Tepetop/Weather-Station/README.md

# Stacja pogodowa

Coś tu dopisze jeszcze

## AI coding harness

Lokalny agent Python do analizy i edycji kodu STM32, z automatyczną kompilacją
trzech wariantów projektu i testami hosta.

Instrukcja instalacji i przykłady: [tools/ai_harness/README.md](tools/ai_harness/README.md).
