Tepetop/Weather-Station/outdoorPCB/OutdoorMeasureUnit.kicad_pcb

## KiCad design outdoorPCB/OutdoorMeasureUnit.kicad_pcb (2026-09-27)

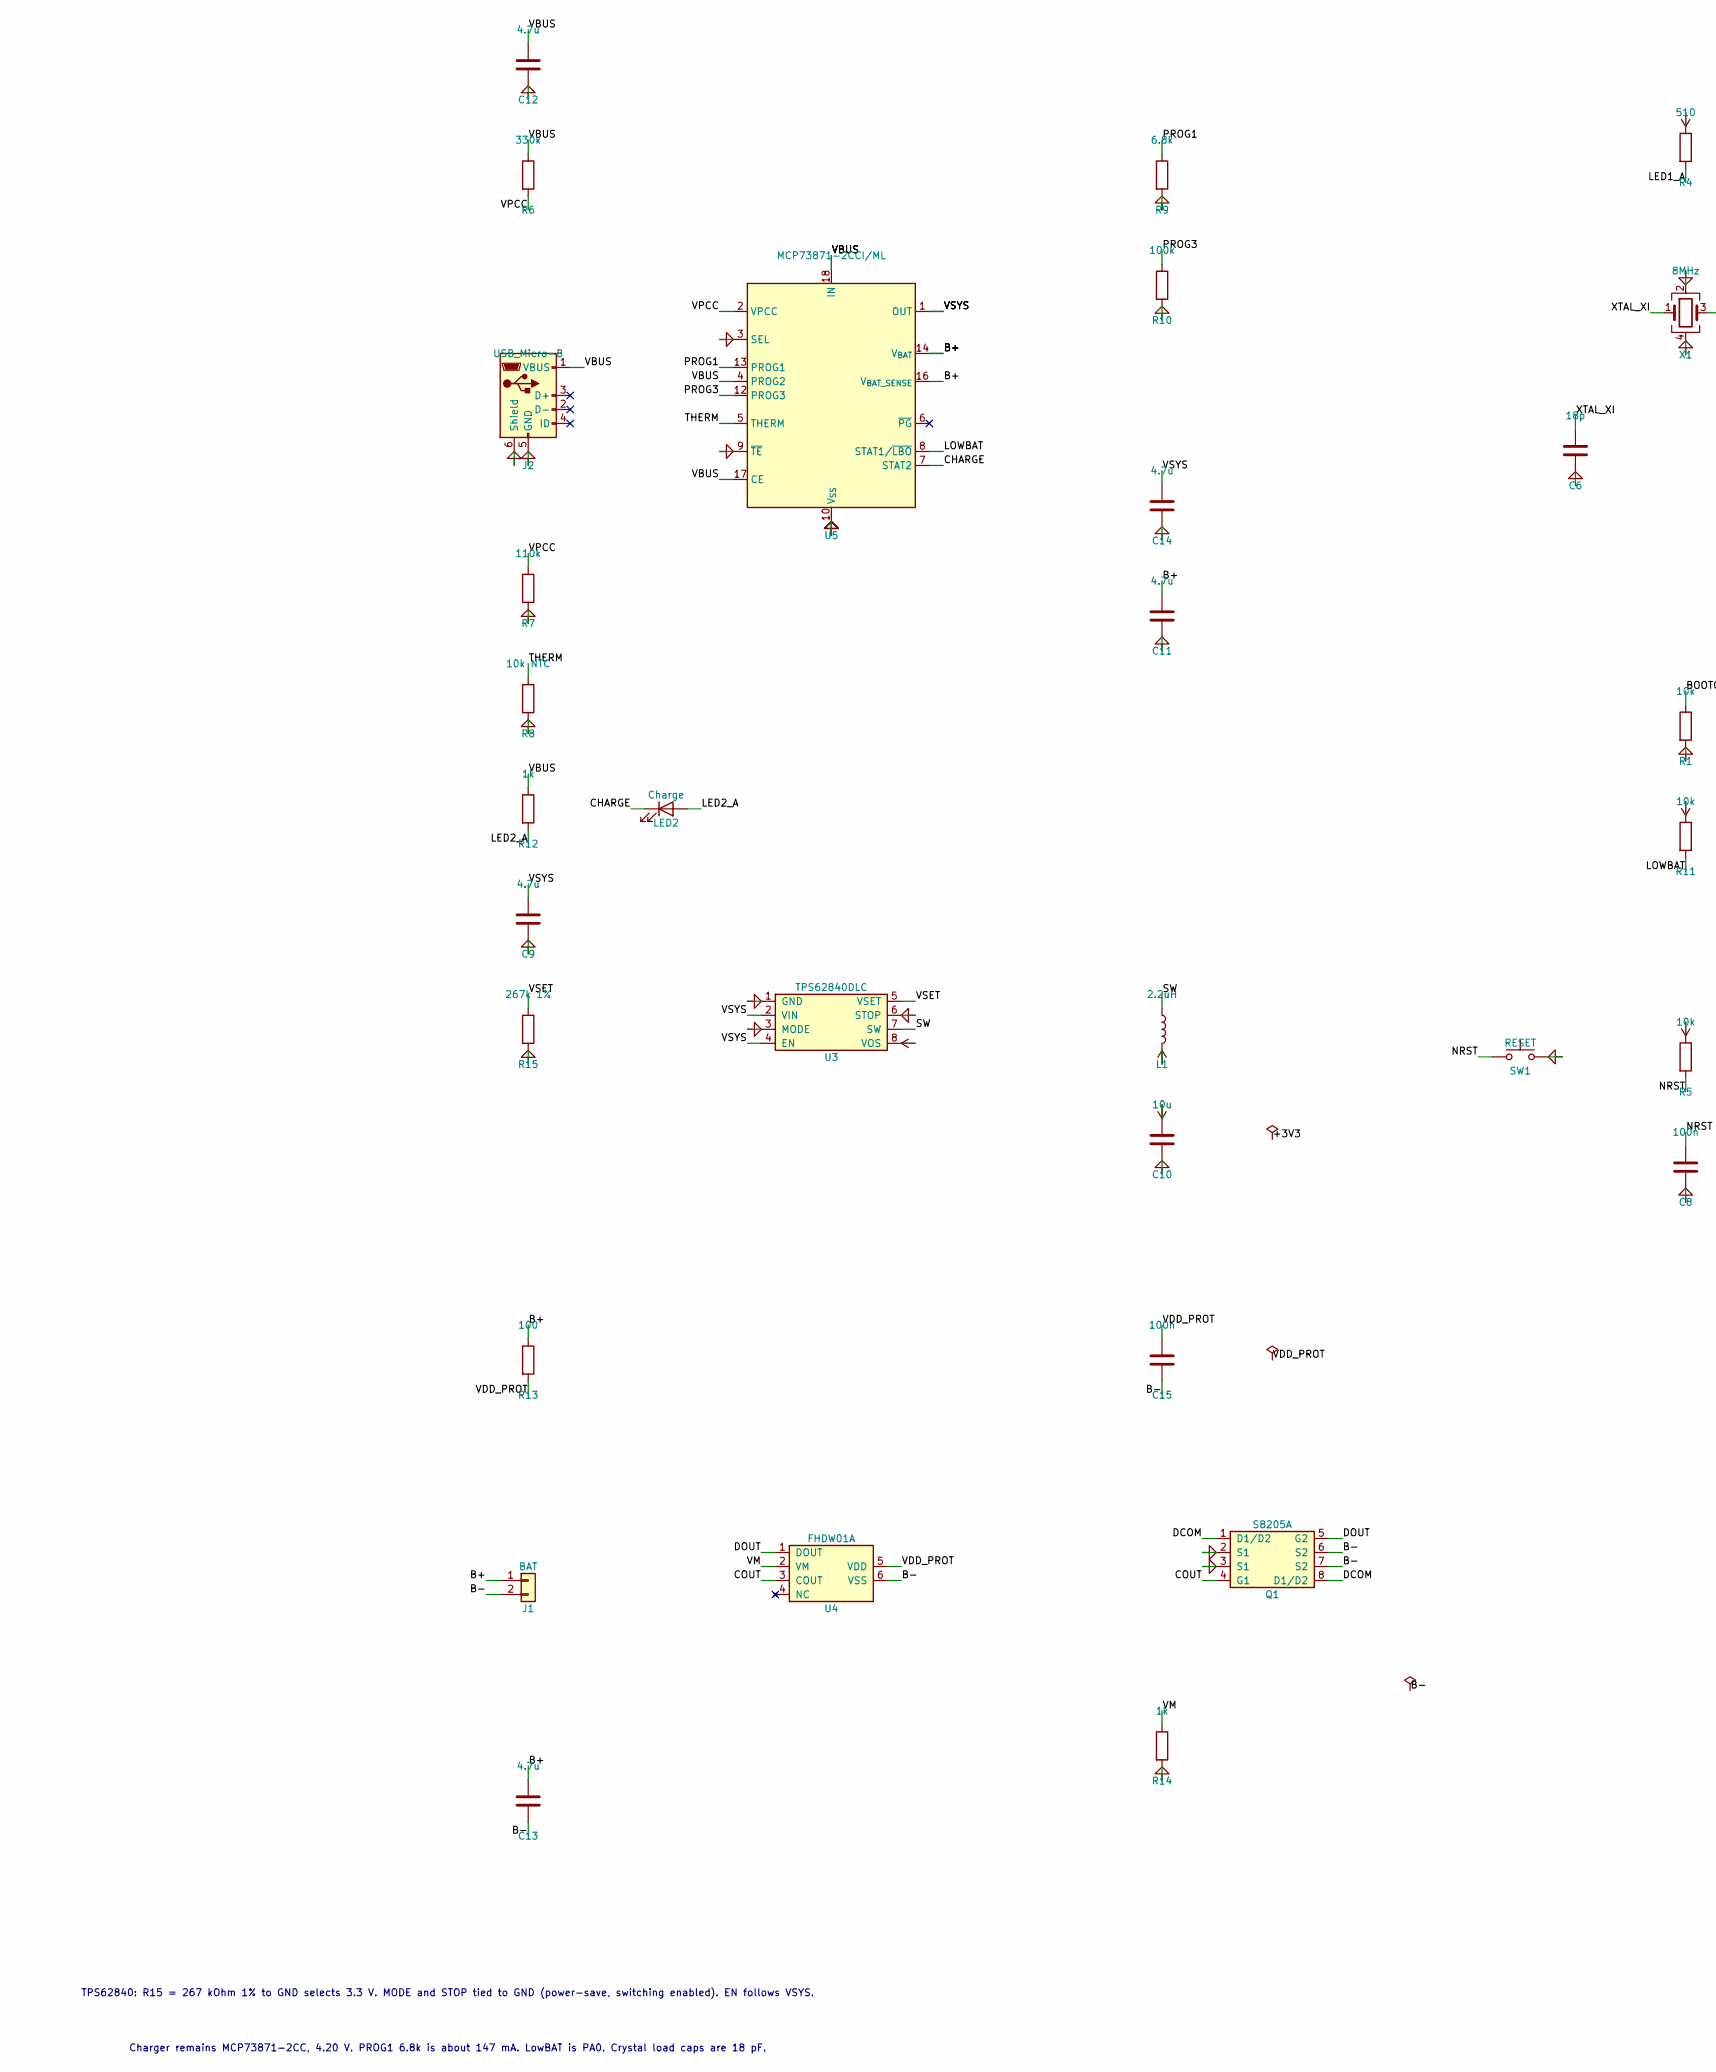
[picture p1: schematic OutdoorMeasureUnit.kicad_sch, part in row 1, column 1]

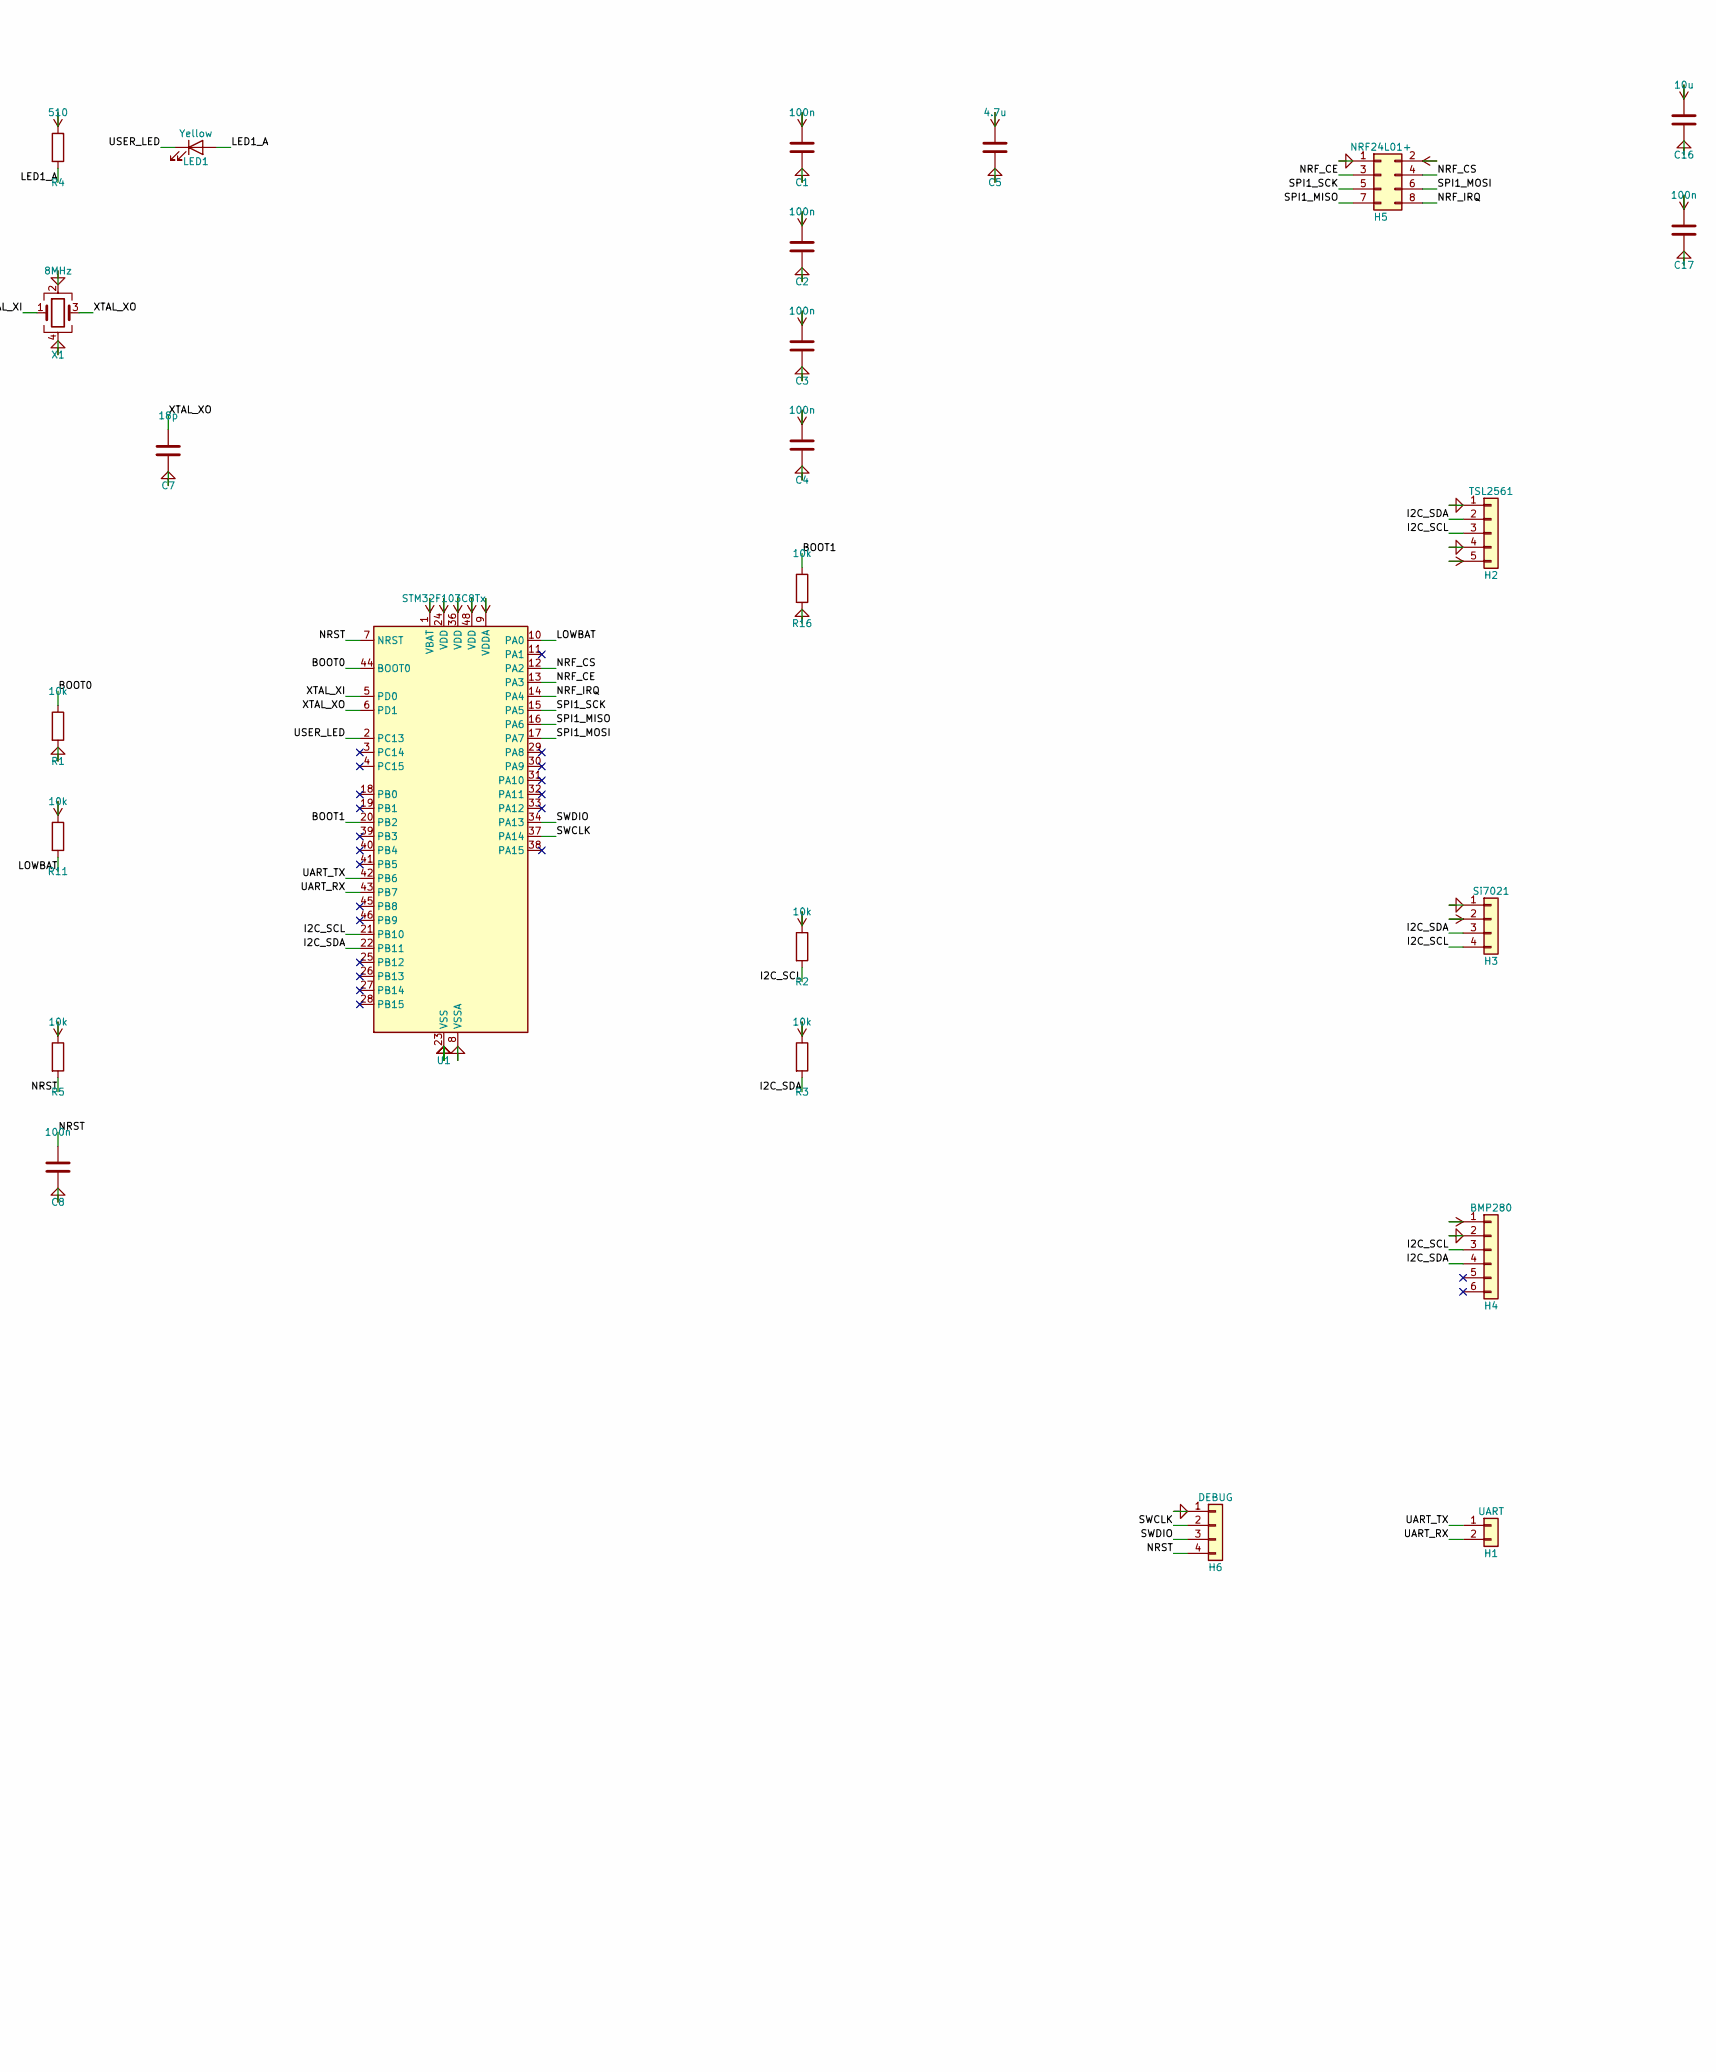
[picture p2: schematic OutdoorMeasureUnit.kicad_sch, part in row 1, column 2]

Parts:
C1, C2, C3, C4, C8, C15, C17: 100n; C_0402_1005Metric
C5, C9, C11, C12, C13, C14: 4.7u; C_0603_1608Metric
C6, C7: 18p; C_0402_1005Metric
C10, C16: 10u; C_0603_1608Metric
H1: UART; PinHeader_1x02_P2.54mm_Vertical
H2: TSL2561; PinHeader_1x05_P2.54mm_Vertical
H3: Si7021; PinHeader_1x04_P2.54mm_Vertical
H4: BMP280; PinHeader_1x06_P2.54mm_Vertical
H5: NRF24L01+; PinHeader_2x04_P2.54mm_Vertical
H6: DEBUG; PinHeader_1x04_P2.54mm_Vertical
J1: BAT; JST_PH_B2B-PH-K_1x02_P2.00mm_Vertical
J2: USB_Micro-B; USB_Micro-B_Molex_47346-0001
L1: 2.2uH; L_Cenker_CKCS201610
LED1: Yellow; LED_0402_1005Metric
LED2: Charge; LED_0402_1005Metric
Q1: S8205A; TSSOP-8_4.4x3mm_P0.65mm
R1, R2, R3, R5, R11, R16: 10k; R_0402_1005Metric
R4: 510; R_0402_1005Metric
R6: 330k; R_0402_1005Metric
R7: 110k; R_0402_1005Metric
R8: 10k NTC; R_0402_1005Metric
R9: 6.8k; R_0402_1005Metric
R10: 100k; R_0402_1005Metric
R12, R14: 1k; R_0402_1005Metric
R13: 100; R_0402_1005Metric
R15: 267k 1%; R_0402_1005Metric
SW1: RESET; SW_SPST_B3U-1000P
U1: STM32F103C8Tx; LQFP-48_7x7mm_P0.5mm
U3: TPS62840DLC; Texas_VSON-HR-8_1.5x2mm_P0.5mm
U4: FHDW01A; SOT-23-6
U5: MCP73871-2CCI/ML; QFN-20-1EP_4x4mm_P0.5mm_EP2.5x2.5mm
X1: 8MHz; Crystal_SMD_3225-4Pin_3.2x2.5mm

Connections:
+3V3: C1.1, C2.1, C3.1, C4.1, C5.1, C10.1, C16.1, C17.1, H2.5, H3.2, H4.1, H5.2, L1.2, R2.1, R3.1, R4.1, R5.1, R11.1, U1.1 (VBAT), U1.9 (VDDA), U1.24 (VDD), U1.36 (VDD), U1.48 (VDD), U3.8 (VOS)
B+: C11.1, C13.1, J1.1, R13.1, U5.14 (V_{BAT}), U5.15 (V_{BAT}), U5.16 (V_{BAT_SENSE})
B-: C13.2, C15.2, J1.2, Q1.6 (S2), Q1.7 (S2), U4.6 (VSS)
BOOT0: R1.1, U1.44 (BOOT0)
BOOT1: R16.1, U1.20 (PB2)
CHARGE: LED2.1 (K), U5.7 (STAT2)
COUT: Q1.4 (G1), U4.3 (COUT)
DCOM: Q1.1 (D1/D2), Q1.8 (D1/D2)
DOUT: Q1.5 (G2), U4.1 (DOUT)
GND: C1.2, C2.2, C3.2, C4.2, C5.2, C6.2, C7.2, C8.2, C9.2, C10.2, C11.2, C12.2, C14.2, C16.2, C17.2, H2.1, H2.4, H3.1, H4.2, H5.1, H6.1, J2.5 (GND), J2.6 (Shield), Q1.2 (S1), Q1.3 (S1), R1.2, R7.2, R8.2, R9.2, R10.2, R14.2, R15.2, R16.2, SW1.2, U1.8 (VSSA), U1.23 (VSS), U1.35 (VSS), U1.47 (VSS), U3.1 (GND), U3.3 (MODE), U3.6 (STOP), U5.3 (SEL), U5.9 (~TE), U5.10 (V_{SS}), U5.11 (V_{SS}), U5.21 (V_{SS}), X1.2, X1.4
I2C_SCL: H2.3, H3.4, H4.3, R2.2, U1.21 (PB10)
I2C_SDA: H2.2, H3.3, H4.4, R3.2, U1.22 (PB11)
LED1_A: LED1.2 (A), R4.2
LED2_A: LED2.2 (A), R12.2
LOWBAT: R11.2, U1.10 (PA0), U5.8 (STAT1/~LBO)
NRF_CE: H5.3, U1.13 (PA3)
NRF_CS: H5.4, U1.12 (PA2)
NRF_IRQ: H5.8, U1.14 (PA4)
NRST: C8.1, H6.4, R5.2, SW1.1, U1.7 (NRST)
PROG1: R9.1, U5.13 (PROG1)
PROG3: R10.1, U5.12 (PROG3)
SPI1_MISO: H5.7, U1.16 (PA6)
SPI1_MOSI: H5.6, U1.17 (PA7)
SPI1_SCK: H5.5, U1.15 (PA5)
SW: L1.1, U3.7 (SW)
SWCLK: H6.2, U1.37 (PA14)
SWDIO: H6.3, U1.34 (PA13)
THERM: R8.1, U5.5 (THERM)
UART_RX: H1.2, U1.43 (PB7)
UART_TX: H1.1, U1.42 (PB6)
USER_LED: LED1.1 (K), U1.2 (PC13)
VBUS: C12.1, J2.1 (VBUS), R6.1, R12.1, U5.4 (PROG2), U5.17 (CE), U5.18 (IN), U5.19 (IN)
VDD_PROT: C15.1, R13.2, U4.5 (VDD)
VM: R14.1, U4.2 (VM)
VPCC: R6.2, R7.1, U5.2 (VPCC)
VSET: R15.1, U3.5 (VSET)
VSYS: C9.1, C14.1, U3.2 (VIN), U3.4 (EN), U5.1 (OUT), U5.20 (OUT)
XTAL_XI: C6.1, U1.5 (PD0), X1.1
XTAL_XO: C7.1, U1.6 (PD1), X1.3

Notes on the sheet:
TPS62840: R15 = 267 kOhm 1% to GND selects 3.3 V. MODE and STOP tied to GND (power-save, switching enabled). EN follows VSYS.
Charger remains MCP73871-2CC, 4.20 V. PROG1 6.8k is about 147 mA. LowBAT is PA0. Crystal load caps are 18 pF.

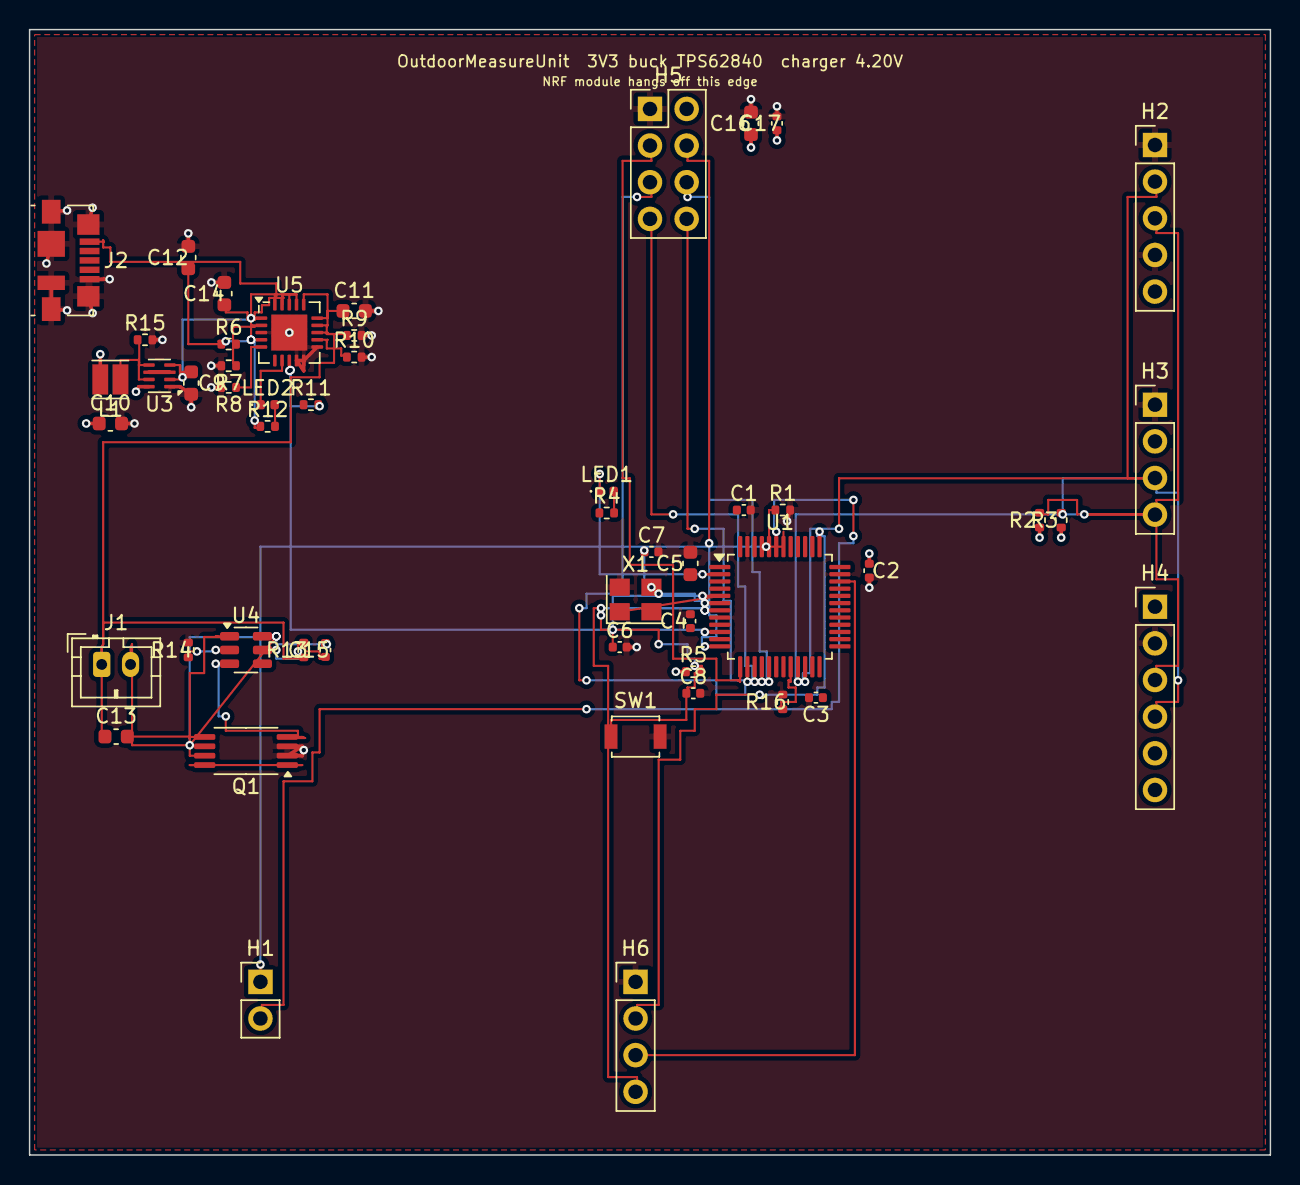
[picture p3: board OutdoorMeasureUnit.kicad_pcb from above]

Board: 4 copper layers, 86.0 x 78.0 mm, 51 parts (0 on the bottom side), 39 nets.
