Tepetop/Weather-Station/IndoorUnit_newMCU/Core/Src/main.c

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
/* Includes ------------------------------------------------------------------*/
#include "main.h"
#include "dma.h"
#include "fatfs.h"
#include "i2c.h"
#include "spi.h"
#include "tim.h"
#include "usart.h"
#include "wwdg.h"
#include "gpio.h"

/* USER CODE BEGIN Includes */
#include <PCD_LCD/PCD8544.h>
#include <PCD_LCD/PCD8544_fonts.h>
#include <PCD_LCD/PCD8544_Menu.h>
#include <PCD_LCD/PCD8544_Menu_config.h>
#include <PCD_LCD/PCD8544_Drawing.h>

#include <complex.h>
#include <stdbool.h>
#include <stdint.h>
#include <stdio.h>
#include <string.h>
#include <sys/_types.h>

#include "weather_station_config.h"
#include "debug_log.h"
#include "uart_cmd.h"
#include "power_mgr.h"
#include "sd_logger.h"
/* USER CODE END Includes */


void SystemClock_Config(void);
/* USER CODE BEGIN PFP */

void EncoderButtonPress(void);
static void NRF_DelayUs(uint32_t us);
void RTC_alarm1(void);
void RTC_alarm2(void);
static bool RTC_IsManualSetRequestedAtBoot(void);
void Menu_EscapeWraper (void);

/* USER CODE END PFP */

/**
  * @brief  The application entry point.
  * @retval int
  */
int main(void)
{

  /* MCU Configuration--------------------------------------------------------*/

  /* Reset of all peripherals, Initializes the Flash interface and the Systick. */
  HAL_Init();

  /* Configure the system clock */
  SystemClock_Config();

  /* Initialize all configured peripherals */
  MX_GPIO_Init();
  MX_DMA_Init();
  MX_I2C2_Init();
  MX_SPI1_Init();
  MX_SPI2_Init();
  MX_TIM1_Init();
  MX_USART1_UART_Init();
  MX_FATFS_Init();
  /* USER CODE BEGIN 2 */
  /* Do NOT call MX_WWDG_Init() here (Cube may regenerate it above): WWDG must
   * start only after long boot init, with Prescaler=8 / Window=126 / Counter=127. */
  /* SPI1 shared by LCD + SD: keep CS idle-high before talking to either. */


  bool rtcManualSetRequested = RTC_IsManualSetRequestedAtBoot();

  /*            Initialize encoder        */
  Encoder_Init(&encoder, &htim1, TIM_CHANNEL_1, TIM_CHANNEL_2);   

  /*             Initialize debounce button        */
  ButtonInitKey(&encoderSW, ENC_BUTTON_GPIO_Port, ENC_BUTTON_Pin, 50, 1000, 500, BUTTON_MODE_INTERRUPT);
  ButtonRegisterPressCallback(&encoderSW, EncoderButtonPress);

  /*            Initialize LCD           */
  if(PCD8544_Init(&LCD, &hspi1, LCD_DC_GPIO_Port, LCD_DC_Pin, LCD_CE_GPIO_Port, LCD_CE_Pin, LCD_RST_GPIO_Port, LCD_RST_Pin, LCD_BLK_GPIO_Port, LCD_BLK_Pin) != PCD_OK) {
    Error_Handler();
  }
  else {
  {
    PCD8544_ClearScreen(&LCD);
  }
  }
 
  /*            Initialize RTC        */
  if (DS3231_Init(&rtc, &hi2c2, RTC_SQW_GPIO_Port, RTC_SQW_Pin, DS3231_I2C_ADDR, DS3231_FORMAT_24H) != DS3231_OK) {
    Error_Handler();
  }

  if (DS3231_GetOscillatorStopFlag(&rtc) != DS3231_OK) {
    Error_Handler();
  }

  if (rtcManualSetRequested || rtc.oscilator_stopped) 
  {
    /* Set time once on manual request or after oscillator stop (OSF=1). */
    if (DS3231_SetDateTime(&rtc, &currentDateTime) != DS3231_OK) {
      Error_Handler();
    }

    if (DS3231_ClearOscillatorStopFlag(&rtc) != DS3231_OK) {
      Error_Handler();
    }

    rtcNow = currentDateTime;
  } else {
    if (DS3231_GetDateTime(&rtc, &rtcNow) != DS3231_OK) {
      Error_Handler();
    }
  }

  DS3231_SetAlarm1(&rtc, &RTCalarm1);
  DS3231_SetAlarm2(&rtc, &RTCalarm2);
  DS3231_EnableAlarm1Interrupt(&rtc);
  DS3231_EnableAlarm2Interrupt(&rtc);

  /* UART + RTC are up: start debug log before SD so init messages are visible. */
  Debug_Init();

  /* SD mount is best-effort — missing card must not block the station. */
  (void)SD_Logger_Init();


  /* Initialize menu system with predefined configuration */
  Menu_Init(&StronaDomyslna, &menuContext); 
  // Set font for menu display
  PCD8544_SetFont(&LCD, &Font_6x8);  
  // Display initial menu and then show default measurement screen
  Menu_RefreshDisplay(&LCD, &menuContext);
  
  /* Initialize charts (no-op when WS_UI_CHARTS_ENABLED == 0) */
  WS_UI_InitCharts();

  /* ---------------------------------------------------------------
   * NRF24L01 Weather Station Initialization
   * --------------------------------------------------------------- */

  /* 1. Initialize nRF24L01 driver handle. */
  if (NRF24_Init(&nrf, &hspi2, NRF_CS_GPIO_Port, NRF_CS_Pin, NRF_CE_GPIO_Port, NRF_CE_Pin, NRF_IRQ_GPIO_Port, NRF_IRQ_Pin, NRF_DelayUs) != HAL_OK) 
  {
    PCD8544_SetFont(&LCD, &Font_6x8);
    PCD8544_SetCursor(&LCD, 0, 0);
    PCD8544_WriteString(&LCD, "NRF FAIL");
    PCD8544_UpdateScreen(&LCD);
    Error_Handler();
  }

  if (NRF24_IsPresent(&nrf) != HAL_OK)
  {
    PCD8544_SetFont(&LCD, &Font_6x8);
    PCD8544_SetCursor(&LCD, 0, 0);
    PCD8544_WriteString(&LCD, "NRF MISS");
    PCD8544_UpdateScreen(&LCD);
    Error_Handler();
  }

  WS_InitManager(&wsCtx, WS_NODE_TX_ADDRS, WS_NODE_RX_ADDRS, WS_NODE_COUNT);


  /*  Initialize Weather Station Runtime struct   */  
  wsRuntime.nrf = &nrf;
  wsRuntime.lcd = &LCD;
  wsRuntime.rtc_now = &rtcNow;
  wsRuntime.text_buffer = g_nrf_message;
  wsRuntime.text_buffer_size = sizeof(g_nrf_message);
  wsRuntime.led_port = USER_LED_GPIO_Port;
  wsRuntime.led_pin = USER_LED_Pin;
  wsRuntime.channel = NRF_CHANNEL;
  wsRuntime.cmd_measure = CMD_MEASURE;
  wsRuntime.cmd_size = NRF_CMD_SIZE;
  wsRuntime.payload_size = NRF_PAYLOAD_SIZE;
  wsRuntime.tx_irq_timeout_ms = NRF_TX_IRQ_TIMEOUT_MS;
  wsRuntime.rx_timeout_ms = NRF_RX_TIMEOUT_MS;
  wsRuntime.comm_watchdog_timeout_ms = NRF_COMM_WATCHDOG_TIMEOUT_MS;
  wsRuntime.huart_pico = &huart1;
  wsRuntime.broadcast_addr = NRF_BROADCAST_ADDR;

  /*  If NRF24L01 initialization fails, display error on LCD , go to error handler*/
  if (WS_InitRadioAndStart(&wsCtx, &wsRuntime) != HAL_OK) {
    PCD8544_SetFont(&LCD, &Font_6x8);
    PCD8544_SetCursor(&LCD, 0, 0);
    PCD8544_WriteString(&LCD, "WS INIT ERR");
    PCD8544_UpdateScreen(&LCD);
    Error_Handler();
  }

  /* Initialize UI context for weather station display functions */
  WS_UI_Init(&WS_UI, &wsCtx, &wsRuntime, &LCD, &menuContext, &encoder, &rtcNow, g_nrf_message, sizeof(g_nrf_message), &rtc);

  UartCmd_Init(&huart1, &wsCtx);

  /* Force initial measurement display render (show time + placeholders) */
  WS_UI.chart_data_dirty = 1U;

  /*  Initial measurement request */
  WS_RequestMeasurementCycle(&wsCtx);

  /* Start WWDG only after long boot-time initialization is complete. */
  MX_WWDG_Init();
  uint32_t wwdg_last_refresh_tick = HAL_GetTick();

  PowerMgr_Init();

  /* USER CODE END 2 */

  /* Infinite loop */
  /* USER CODE BEGIN WHILE */
  while (1)
  {
    /* USER CODE END WHILE */

    /* USER CODE BEGIN 3 */

    uint32_t now_tick = HAL_GetTick();

    /* Flush buffered UART reply first so ACK reaches Pico before NRF logs. */
    UartCmd_FlushReply();

    /*  Process with NRF24  */
    WS_ProcessEventHandler(&wsCtx, &wsRuntime, now_tick);

    /*    Process with RTC event     */
    DS3231_EventHandler(&rtc, &rtcNow, RTC_alarm1, RTC_alarm2);

    /*    Process with button event routine    */
    ButtonTask(&encoderSW);

    /* View state machine handles chart, status, measurement and menu views */
    WS_UI_ViewTask();

    /* Keep WWDG alive only while communication watchdog is healthy. */
    uint32_t wwdg_now_tick = HAL_GetTick();
    if ((wsCtx.comm_watchdog_tripped == 0U) && ((wwdg_now_tick - wwdg_last_refresh_tick) >= WWDG_REFRESH_PERIOD_MS)) 
    {
      WWDG_TryRefresh();
      wwdg_last_refresh_tick = wwdg_now_tick;
    }

    /* Debug heartbeat - logs every minute to detect program hangs */
    #ifdef DEBUG_LOG_HEARTBEAT
        Debug_Heartbeat();
    #endif

    if ((menuContext.state.InScreenSaver != 0U) &&
        (encoder.ButtonIRQ_Flag == 0U) &&
        (encoderSW.InterruptFlag == 0U) &&
        (encoder.IRQ_Flag == 0U) &&
        (WS_CanSleep(&wsCtx) != 0U))
    {
      PowerMgr_EnterIdleStop(&nrf);
    }

  }
  /* USER CODE END 3 */
}

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
/* USER CODE BEGIN 4 */

/*      Encoder timer handler     */
void HAL_TIM_IC_CaptureCallback(TIM_HandleTypeDef *htim){
  /*   Check if the interrupt is from TIM1*/
  if (htim->Instance == TIM1)
  {
    encoder.IRQ_Flag = IRQ_FLAG_SET;
  }
}

/*      Encoder button IRQ handler      */
void HAL_GPIO_EXTI_Callback(uint16_t GPIO_Pin)
{
  /*Encoder button IRQ handler*/
  ButtonIRQHandler(&encoderSW, GPIO_Pin);

  /* RTC SQW/INT pin IRQ handler */
  DS3231_IRQHandler(&rtc, GPIO_Pin);

  /* NRF24L01 IRQ pin (active low) */
  if (GPIO_Pin == NRF_IRQ_Pin)
  {
    WS_SetIrqFlag(&wsCtx);
  }
}

/*                PRIVATE FUNCTIONS                             */

/**
 * @brief Microsecond delay using DWT cycle counter.
 */
static void NRF_DelayUs(uint32_t us) {
  CoreDebug->DEMCR |= CoreDebug_DEMCR_TRCENA_Msk;
  DWT->CYCCNT = 0;
  DWT->CTRL |= DWT_CTRL_CYCCNTENA_Msk;

  uint32_t cycles = (SystemCoreClock / 1000000U) * us;
  uint32_t start = DWT->CYCCNT;
  while ((DWT->CYCCNT - start) < cycles);
}

/* RTC alarm function assign to callback */
void RTC_alarm1(void){
  WS_UI.chart_data_dirty = 1U;
#ifdef DEBUG_LOG_RTC1_EVENTS
  Debug_LogRtcAlarm1();
#endif
}

/* RTC alarm function assign to callback */
void RTC_alarm2(void){
  WS_RequestMeasurementCycle(&wsCtx);
#ifdef DEBUG_LOG_RTC2_EVENTS
  Debug_LogRtcAlarm2();
#endif
}

/*      Encoder button function to assign to callback     */
void EncoderButtonPress(void)
{
  encoder.ButtonIRQ_Flag = IRQ_FLAG_SET;
  Menu_SetEnterAction(&menuContext);
}

void Menu_EscapeWraper(void)
{
    Menu_Escape(&LCD, &menuContext);
};

/* Hold encoder button during boot to force one-time manual RTC update. */
static bool RTC_IsManualSetRequestedAtBoot(void){
  uint32_t startTick = HAL_GetTick();

  if (HAL_GPIO_ReadPin(ENC_BUTTON_GPIO_Port, ENC_BUTTON_Pin) != GPIO_PIN_RESET) {
    return false;
  }

  while ((HAL_GetTick() - startTick) < RTC_MANUAL_SET_HOLD_MS) {
    if (HAL_GPIO_ReadPin(ENC_BUTTON_GPIO_Port, ENC_BUTTON_Pin) != GPIO_PIN_RESET) {
      return false;
    }
  }

  return true;
}

/* USER CODE END 4 */
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
