Tepetop/Weather-Station/IndoorUnit_newMCU/Core/Inc/main.h

#define USER_LED_Pin GPIO_PIN_13
#define USER_LED_GPIO_Port GPIOC
#define LCD_BLK_Pin GPIO_PIN_14
#define LCD_BLK_GPIO_Port GPIOC
#define LCD_DC_Pin GPIO_PIN_2
#define LCD_DC_GPIO_Port GPIOA
#define LCD_CE_Pin GPIO_PIN_3
#define LCD_CE_GPIO_Port GPIOA
#define LCD_RST_Pin GPIO_PIN_4
#define LCD_RST_GPIO_Port GPIOA
#define SPI1_CLK_Pin GPIO_PIN_5
#define SPI1_CLK_GPIO_Port GPIOA
#define SPI1_MOSI_Pin GPIO_PIN_7
#define SPI1_MOSI_GPIO_Port GPIOA
#define SD_CS_Pin GPIO_PIN_0
#define SD_CS_GPIO_Port GPIOB
#define RTC_SQW_Pin GPIO_PIN_1
#define RTC_SQW_GPIO_Port GPIOB
#define RTC_SQW_EXTI_IRQn EXTI1_IRQn
#define RTC_SCL_Pin GPIO_PIN_10
#define RTC_SCL_GPIO_Port GPIOB
#define RTC_SDA_Pin GPIO_PIN_11
#define RTC_SDA_GPIO_Port GPIOB
#define NRF_CS_Pin GPIO_PIN_12
#define NRF_CS_GPIO_Port GPIOB
#define NRF_SCK_Pin GPIO_PIN_13
#define NRF_SCK_GPIO_Port GPIOB
#define NRF_MISO_Pin GPIO_PIN_14
#define NRF_MISO_GPIO_Port GPIOB
#define NRF_MOSI_Pin GPIO_PIN_15
#define NRF_MOSI_GPIO_Port GPIOB
#define ENC_CH1_Pin GPIO_PIN_8
#define ENC_CH1_GPIO_Port GPIOA
#define ENC_CH2_Pin GPIO_PIN_9
#define ENC_CH2_GPIO_Port GPIOA
#define ENC_BUTTON_Pin GPIO_PIN_10
#define ENC_BUTTON_GPIO_Port GPIOA
#define ENC_BUTTON_EXTI_IRQn EXTI15_10_IRQn
#define NRF_IRQ_Pin GPIO_PIN_11
#define NRF_IRQ_GPIO_Port GPIOA
#define NRF_IRQ_EXTI_IRQn EXTI15_10_IRQn
#define NRF_CE_Pin GPIO_PIN_12
#define NRF_CE_GPIO_Port GPIOA
#define SD_SPI_HANDLE hspi1
