Tepetop/Weather-Station/IndoorUnit_newMCU/Core/Inc/Sensors/encoder.h

/**
 * @file    encoder.h
 * @brief   Rotary encoder driver for STM32 timer encoder mode
 * @details Reads hardware timer counter deltas and direction (CR1.DIR bit),
 *          accumulates pulse count, and maps rotation to menu navigation.
 */

#ifndef ENCODER_H
#define ENCODER_H

#include "main.h"
#include "PCD8544_Menu.h"


#define ENCODER_TIMER_MIDDLE  0x7FFF
/**
 * @brief Encoder rotation direction (mirrors hardware DIR bit in TIMx->CR1).
 *
 * In encoder mode the timer hardware sets the DIR bit automatically:
 *   DIR = 0 → counter counts UP   → forward  (pin A pulses)
 *   DIR = 1 → counter counts DOWN → backward (pin B pulses)
 */
typedef enum
{
	ENCODER_DIR_FORWARD  = 0,   /**< Counting up   – pin A impulses dominate */
	ENCODER_DIR_BACKWARD = 1    /**< Counting down  – pin B impulses dominate */
} Encoder_Direction_t;

/**
 * @brief Encoder instance structure.
 */
typedef struct
{
	TIM_HandleTypeDef      *EncTim;          /**< Timer handle (encoder mode)            */
	uint16_t                PrevCounter;     /**< Previous CNT snapshot for delta calc    */
	int32_t                 PulseCount;      /**< Net accumulated pulse count (+/-)       */
	Encoder_Direction_t     Direction;       /**< Current direction from CR1.DIR bit      */
	volatile uint8_t        IRQ_Flag;        /**< Set in TIM capture-compare ISR          */
	volatile uint8_t        ButtonIRQ_Flag;  /**< Set in EXTI (button) ISR                */
} Encoder_t;

/* ============================================================================
 * Public API
 * ============================================================================ */

/**
 * @brief   Initializes encoder instance and starts timer in encoder mode
 * @param   encoder   Encoder handle to initialize
 * @param   timer     HAL timer configured for encoder mode
 * @param   channel1  First encoder channel (e.g. TIM_CHANNEL_1)
 * @param   channel2  Second encoder channel (e.g. TIM_CHANNEL_2)
 * @retval  HAL_OK     Initialization successful
 * @retval  HAL_ERROR  NULL pointer argument
 */
HAL_StatusTypeDef   Encoder_Init(Encoder_t *encoder, TIM_HandleTypeDef *timer,
                                 uint32_t channel1, uint32_t channel2);

/**
 * @brief   Samples timer counter and accumulates pulse delta
 * @param   encoder  Encoder handle
 * @retval  HAL_OK     Update successful
 * @retval  HAL_ERROR  NULL pointer argument
 */
HAL_StatusTypeDef   Encoder_Update(Encoder_t *encoder);

/**
 * @brief   Returns current rotation direction from hardware DIR bit
 * @param   encoder  Encoder handle (read-only)
 * @retval  ENCODER_DIR_FORWARD or ENCODER_DIR_BACKWARD
 */
Encoder_Direction_t Encoder_GetDirection(const Encoder_t *encoder);

/**
 * @brief   Returns accumulated signed pulse count
 * @param   encoder  Encoder handle (read-only)
 * @retval  Net pulse count (positive = forward, negative = backward)
 */
int32_t             Encoder_GetPulseCount(const Encoder_t *encoder);

/**
 * @brief   Resets accumulated pulse count to zero
 * @param   encoder  Encoder handle
 * @retval  None
 */
void                Encoder_ResetPulseCount(Encoder_t *encoder);

/**
 * @brief   Consumes one pulse and updates menu navigation action
 * @param   encoder  Encoder handle
 * @param   context  Active menu context
 * @retval  None
 */
void                Encoder_ManageCursorPosition(Encoder_t *encoder, Menu_Context_t *context);

/**
 * @brief   Main-loop task: processes IRQ flags and menu cursor
 * @param   encoder  Encoder handle
 * @param   context  Active menu context
 * @retval  None
 */
void                Encoder_Task(Encoder_t *encoder, Menu_Context_t *context);

#endif /* ENCODER_H */
