Tepetop/Weather-Station/IndoorUnit_newMCU/Core/Src/Sensors/PCD_LCD/PCD8544_fonts.c

/**
 * @file PCD8544_fonts.c
 * @brief Bitmap font glyph data for the PCD8544 display.
 * @details Implements ASCII bitmap arrays and PCD8544_Font_t descriptors
 *          selected at compile time via PCD8544_config.h.
 */

#include "PCD8544_fonts.h"


// Characters definition
#ifdef PCD8544_INCLUDE_FONT6x8
const uint16_t F6x8[] =
{
	0x00, 0x00, 0x00, 0x00, 0x00, 0x00 ,			 // 20 space
	0x00, 0x00, 0x4f, 0x00, 0x00, 0x00 ,			 // 21 !
	0x00, 0x07, 0x00, 0x07, 0x00, 0x00 ,		 // 22 "
	0x14, 0x7f, 0x14, 0x7f, 0x14, 0x00 ,		 // 23 #
	0x24, 0x2a, 0x7f, 0x2a, 0x12, 0x00 ,		 // 24 $
	0x23, 0x13, 0x08, 0x64, 0x62, 0x00 ,		 // 25 %
	0x36, 0x49, 0x55, 0x22, 0x50, 0x00 ,		 // 26 &
	0x00, 0x05, 0x03, 0x00, 0x00, 0x00 ,		 // 27 '
	0x00, 0x1c, 0x22, 0x41, 0x00, 0x00 ,		 // 28 (
	0x00, 0x41, 0x22, 0x1c, 0x00, 0x00 ,		 // 29 )
	0x14, 0x08, 0x3e, 0x08, 0x14, 0x00 ,		 // 2a *
	0x08, 0x08, 0x3e, 0x08, 0x08, 0x00 ,		 // 2b +
	0x00, 0x50, 0x30, 0x00, 0x00, 0x00 ,		 // 2c ,
	0x08, 0x08, 0x08, 0x08, 0x08, 0x00 ,		 // 2d -
	0x00, 0x60, 0x60, 0x00, 0x00, 0x00 ,		 // 2e .
	0x20, 0x10, 0x08, 0x04, 0x02, 0x00 ,		 // 2f /
	0x3e, 0x51, 0x49, 0x45, 0x3e, 0x00 ,	 // 30 0
	0x00, 0x42, 0x7f, 0x40, 0x00, 0x00 , // 31 1
	0x42, 0x61, 0x51, 0x49, 0x46, 0x00 , // 32 2
	0x21, 0x41, 0x45, 0x4b, 0x31, 0x00 , // 33 3
	0x18, 0x14, 0x12, 0x7f, 0x10, 0x00 , // 34 4
	0x27, 0x45, 0x45, 0x45, 0x39, 0x00 , // 35 5
	0x3c, 0x4a, 0x49, 0x49, 0x30, 0x00 , // 36 6
	0x01, 0x71, 0x09, 0x05, 0x03, 0x00 , // 37 7
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
#endif

#ifdef SSD1306_INCLUDE_FONT_11x18
/** @brief 11×18 pixel ASCII font instance */
const PCD8544_Font_t Font_11x18 = {11, 18, Font11x18};
#endif

#ifdef SSD1306_INCLUDE_FONT_16x26
/** @brief 16×26 pixel ASCII font instance */
const PCD8544_Font_t Font_16x26 = {16, 26, Font16x26};
#endif
