Tepetop/Weather-Station/IndoorUnit_newMCU/Core/Src/Sensors/NRF24L01.c

/**
 * @file    NRF24L01.c
 * @brief   nRF24L01+ 2.4 GHz transceiver driver (SPI)
 * @details STM32 HAL SPI driver for Nordic nRF24L01(+). Provides register
 *          access, TX/RX payload handling, IRQ processing, and radio
 *          configuration (channel, data rate, PA level, pipes, CRC).
 *          Static helpers manage CSN/CE timing and SPI transfers.
 */

#include "NRF24L01.h"
#include <string.h>

/* ---------------------------------------------------------------------------
 * Private (static) helper functions
 * --------------------------------------------------------------------------- */

/**
 * @brief Drives CSN (Chip Select Not) pin low to start SPI transaction.
 * @param handle Pointer to the nRF24 handle structure.
 */
static void csn_low(NRF24_Handle_t *handle) {
    HAL_GPIO_WritePin(handle->csn_port, handle->csn_pin, GPIO_PIN_RESET);
}

/**
 * @brief Drives CSN (Chip Select Not) pin high to end SPI transaction.
 * @param handle Pointer to the nRF24 handle structure.
 */
static void csn_high(NRF24_Handle_t *handle) {
    HAL_GPIO_WritePin(handle->csn_port, handle->csn_pin, GPIO_PIN_SET);
}

/**
 * @brief Drives CE (Chip Enable) pin low to deactivate TX/RX mode.
 * @param handle Pointer to the nRF24 handle structure.
 */
static void ce_low(NRF24_Handle_t *handle) {
    HAL_GPIO_WritePin(handle->ce_port, handle->ce_pin, GPIO_PIN_RESET);
}

/**
 * @brief Drives CE (Chip Enable) pin high to activate TX/RX mode.
 * @param handle Pointer to the nRF24 handle structure.
 */
static void ce_high(NRF24_Handle_t *handle) {
    HAL_GPIO_WritePin(handle->ce_port, handle->ce_pin, GPIO_PIN_SET);
}

/**
 * @brief Forces Standby-I before register configuration writes (CE low).
 * @param handle Pointer to the nRF24 handle structure.
 */
static void ensure_standby(NRF24_Handle_t *handle) {
    ce_low(handle);
}

/**
 * @brief Performs a full-duplex SPI transfer.
 * @param handle Pointer to the nRF24 handle structure.
 * @param tx    Pointer to transmit buffer.
 * @param rx    Pointer to receive buffer.
 * @param len   Number of bytes to transfer.
 * @return HAL status.
 */
static HAL_StatusTypeDef spi_transfer(NRF24_Handle_t *handle, uint8_t *tx, uint8_t *rx, uint16_t len) {
    return HAL_SPI_TransmitReceive(handle->hspi, tx, rx, len, HAL_MAX_DELAY);
}

/**
 * @brief Sends a single-byte SPI command and optionally returns the status byte.
 * @param handle Pointer to the nRF24 handle structure.
 * @param cmd    Command byte to send.
 * @param status Pointer to store the returned status byte (may be NULL).
 * @return HAL status.
 */
static HAL_StatusTypeDef command(NRF24_Handle_t *handle, uint8_t cmd, uint8_t *status) {
    uint8_t tx = cmd;
    uint8_t rx;
    csn_low(handle);
    HAL_StatusTypeDef ret = spi_transfer(handle, &tx, &rx, 1);
    csn_high(handle);
    if (status) *status = rx;
    return ret;
}

/**
 * @brief Writes a multi-byte payload over SPI preceded by a command byte.
 * @param handle Pointer to the nRF24 handle structure.
 * @param cmd    Command byte (e.g. W_TX_PAYLOAD).
 * @param buf    Pointer to the data buffer to write.
 * @param len    Number of payload bytes.
 * @return HAL status.
 */
static HAL_StatusTypeDef write_payload(NRF24_Handle_t *handle, uint8_t cmd, const uint8_t *buf, uint8_t len) {
    csn_low(handle);
    uint8_t tx = cmd;
    uint8_t rx;
    HAL_StatusTypeDef ret = spi_transfer(handle, &tx, &rx, 1);

    if (ret == HAL_OK) {
        uint8_t dummy[NRF24_MAX_PAYLOAD_SIZE];
        ret = spi_transfer(handle, (uint8_t *)buf, dummy, len);
    }
    csn_high(handle);
    return ret;
}
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
