Tepetop/Weather-Station/(commit log)

2025-09-15 Outdoor: Add nessesary files and sensors library
2026-01-19 Add measurement module for Outdoor unit
    Created measurement.c and measurement.h in Outdoor unit/Core to handle
    sensor measurements from si7021, bmp280, and TSL2561 using a state
    machine. Added support for returning measurement data in CSV format.
2026-01-21 Set default configuration for BMP280 sensor
2026-01-21 Refactor measurement module to use device state
2026-01-22 Massive changes in code. Succesfully migrated project from cubeide to vscode. All sensors are working but i have to check if values are correct.
    [main.c, main.h, outdoor_unit_vscode.ioc]
2026-01-22 Fixed group measurement library and added it to main loop
    [bmp280.c, main.c, measurement.c]
2026-01-25 Added DMA support and fixed BMP280 driver
    [NRF24L01.h, bmp280.c, bmp280.h, main.c, measurement.c, outdoor_unit_vscode.ioc]
2026-01-25 BMP280 is working with dma fine
2026-01-27 FIxed error in TSL2561
    [TSL2561.c, measurement.c]
2026-01-30 LCD connected, no errors in files but lcd not displaying anything.
    [PCD8544.c, PCD8544.h, PCD8544_Menu.c, PCD8544_Menu.h, PCD8544_config.h, PCD8544_fonts.c, PCD8544_fonts.h, main.c]
2026-02-05 Added new files for ds3231 and i2c, modified existing files to integrate the new functionality, and updated the project configuration accordingly.
2026-02-11 Added encoder compatibility. Now if user enters submenu, there will be additional "POWROT" option and also menu/submenu name will be displayed on the top of the screen.
2026-02-11 Added ecnoder library. Updated main.c to initialize encoder and LCD, and added a soft timer for LED toggling. Updated menu context and LCD instance declarations.
2026-02-12 Encoder is workingm IRQ form button and timers properly navigate throught menu
2026-02-12 Adde support for IRQ in button debounce library. Succesfully integrated the buton debounce library into the main application and tested it with the encoder button.
2026-02-20 Fixed wrapiing issue when x or y is 0
    [PCD8544_Drawing.c, PCD8544_Drawing.h, main.c]
2026-02-21 First take to fix encoder bug
    [encoder.c, encoder.h, main.c]
2026-02-21 Fiex encoder deadzone at dir change
2026-02-22 Udało się dodać dwie nowe trzcionki na bazie sterownika SSD1306
    [diff.txt]
2026-02-22 Setup B0 pin for IRQ from DS3231
2026-02-22 DS3231 IRQ not working
    [ds3231.c, ds3231.h, main.c, main.h]
2026-02-22 Testuje inna libke od ds3231, dodaje skille do AI
    [diff.txt]
2026-03-08 Zrefaktoryzowano main i measurement.c, dodano measurement_unit_config. Poprawiono przepływ danych, wykasowano flage linkera od float po uart
2026-03-13 Dodano UART do projektu. Nowa opcja screensaver, która sie wlacza po 30 sekundach bezczynności. Jednak nie działa do końca tak jak bym tego chciał
2026-03-17 Poprwka błędów, dodano lepsza obsluge bledow z logowaniem na uart przy aktywnej fladze
2026-03-17 Zmiana przypisania wartosci error code do data.sensorStatus Jedna zmienna o stanie czujnikow jest zbedna ale narazie zostawiam
    [PCD8544.h, PCD8544_Bitmaps.h, button_debounce.h, main.c, measurement.c, outdoor_station.c]
2026-03-29 Dodano rozszerzone logi debugowania w pliku debug_log.c, ogólnie układy działają i problem polega na slabych połączeniach(obecnie płytka stykowa + kabelki)
    [debug_log.c, debug_log.h, main.c, weather_station.c]
2026-04-28 Dodano nowy folder z kodem do pi pico W, zawierajacy serwer reperzentujacy dane pomiarowe. PIco W działa jako dashboard
2026-04-28 Dodano funkcje formatujaca dane pomiarowe do postaci CSV dla pico W wysylane po UART. Nie testowano
2026-04-29 Dodano wyłączenie IWDG podczas debugowania, aby uniknąć resetu systemu podczas zatrzymania CPU przez debugger.
    [debug_log.c, debug_log.h, main.c, outdoor_station.c, outdoor_station.h, outdoor_unit_vscode.ioc, weather_station.c]
2026-07-04 uart_cmd: przetwarzanie linii poza ISR i re-arm RX po błędzie UART
    Odebrana linia jest kolejkowana w przerwaniu i obsługiwana w pętli głównej
    (UartCmd_Process), a HAL_UART_ErrorCallback czyści flagi błędów i wznawia
    odbiór, żeby overrun nie blokował na stałe komend z Pico W.
2026-07-04 uart_cmd: obsługa komend w przerwaniu USART2 i naprawa martwego triggera z Pico
    Strażnik wymagał app_state == WS_APP_IDLE, a po każdym udanym pomiarze
    maszyna stanów zostaje w WS_APP_DATA_READY, więc CMD:MEASURE z serwera
    nigdy nie wyzwalał pomiaru (kolejne komendy dostawały ERR:BUSY).
    WS_APP_DATA_READY jest teraz traktowany jako gotowość do nowego żądania.
    Cała obsługa komendy (parsowanie linii, odpowiedź, ustawienie
    measurement_pending) dzieje się w ISR — usunięto UartCmd_Process
    i polling flagi w pętli głównej.
2026-07-05 fix dla logów alarmu 1 i 2 od RTC. Dodano mechanizm bufora dla UART
    [debug_log.c, main.c, uart_cmd.c, uart_cmd.h]
2026-07-05 fix: brakujących znaków konczących logi
    [main.c, uart_cmd.c, weather_station.c]
2026-07-19 Fix, INDOR: Naprawa zawieszenia się stacji podcas braku ACK od stacji pomiarowych
    [uart_cmd.c, weather_station.c]
2026-07-19 INDOOR/SERW:Dodano obsluge BME280 w indoor, równolegle poprawiono serwer na pico zeby tez to przyjmowal
2026-07-21 INDOR/OUTDOR:ZMiany w timingu miedzy nodami. Nie wgrano jeszcze fixa
    [outdoor_station.c, weather_station.c, weather_station.h, weather_station_config.h]
2026-07-22 FIX:Poprawki w NRF library w celu uzupelnienia zmian z datasheet, poprawiono funckje sprawdzajaca czy NRF jestRDY
    [NRF24L01.c, NRF24L01.h, debug_log.c, main.c, outdoor_station.c]
2026-07-24 Jakiś fix, ogolnie nie dziala jedna stacja pomiarowa. Tam gdzie jest BME
    [measurement_unit_config.h, outdoor_station.c, weather_station.c]
2026-07-30 FEAT: Dodano pierwsza wersje power mgr mode dla IndoorUnit
2026-08-03 Napraw odzysk zapisu SD po błędach i zawieszeniach SPI (#2)
    Po nieudanym zapisie karta była zostawiana w złym stanie bez remountu,
    a busy-wait w sterowniku mógł zawiesić Pico. Dodano odmontowanie/ponowną
    inicjalizację po OSError, timeout przy programowaniu bloku oraz okresowy
    retry gdy startowy mount się nie udał.
2026-08-12 Bardzo duzo zmian, poprawa plików w Inc/Src. Poprawa parametrowmw cube, przenisienie wwdg init poznije w kodzie. Niestety dalej MCU sie resetuje, trzeba testowac bez WWDG czy czytnik wgle dziala praw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
    [IndoorUnit_newMCU.ioc, debug_log.c, debug_log.h, main.c, main.h]
2026-08-13 Duzo zmian. Naprawa dzialania zegarka na LCD(zle bocze w cube), poprawa dzialania power mgr(trzeba jeszcze ocenic), dodanie bibliteki do obslugi karty SD z githuba(od repo z kursu STM), poprawa w log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
2026-08-16 Poprawiono tryb power saver podczas wygaszania ekraniu
2026-08-16 Zamienilem znak @ w foncie 6x8 na znak stopnia dla temperatury
2026-08-18 Dodanie logowanie statusu na kartcie, logi od power saver
2026-08-18 Fix dla niewchodzenia w PWR SAVE
    [weather_station.c]
2026-08-18 Zmiana momentu odświezenie WWDG przed ponownym wyjsciem z PWR MGR zeby nie trigerowało resetu
    [main.c, power_mgr.c, weather_station.h, wwdg.c, wwdg.h]
2026-08-18 Fix resetu MCU przez WWDG w trybie PWR MGR, teraz przycisk powinien działac
    [power_mgr.c, wwdg.c]
2026-08-18 DOdanie kontroli stanu exti od buttona aby wzbudzic ekran w pwr mgr
2026-08-21 Dodano power manager do stacji outdoor. NRF jest ustawiony na RX i oczekuje na wiadomość
2026-08-21 Dodano power manager do stacji outdoor. NRF jest ustawiony na RX i oczekuje na wiadomość" [pwrmgroutdoor 5d7e142] Dodano power manager do stacji outdoor. NRF jest ustawiony na RX i oczekuje na wiadom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
2026-08-22 dodano przełącznik do sensorów dla danej stacji bazujac na NODE_ID
2026-08-22 Dodano kopie porawionej funkcji HAL od power save mode do pliku power mode zeby cube jej nie usunelo
2026-08-24 wyłączono testowo PWR mgr, dla stacji z BME bez power down mode komunikacja działa. Z trybem power mgr nie działa
2026-08-24 Poprawka w obsludze power mode. Dodano WWDG bo IWDG nie bedzie grało z sleep.
2026-09-03 Add reset functionality for outdoor stations
    - Introduced a new menu option for resetting outdoor stations in the PCD8544 menu configuration.
    - Implemented `WS_UI_ResetStation` to queue a software reset for the selected outdoor station.
    - Added `WS_RequestResetForNode` to handle reset requests in the weather station context.
    - Updated UART command handling to support the new reset command.
    - Enhanced protocol definitions to include reset command encoding and decoding.
    - Adjusted measurement logic to check for battery status and reflect it in the UI.
    - Updated Python script for UART communication to include reset command functionality.
    [PCD8544_Menu_config.h, debug_log.c, main.h, measurement.c, measurement_unit_config.h, outdoor_station.c, uart_cmd.c]
2026-09-20 NIe pamiętam co tu było, wiem tyle ze dodałem pin dla poziomu bateri na przyszłość
2026-09-27 Dodanie folderu z plytka PCD z kicad oraz rozszerzenie .gitignore
    [OutdoorMeasureUnit.kicad_pcb, OutdoorMeasureUnit.kicad_sch]
2026-10-01 Add local AI coding harness for STM32 with build verification and Polish guide
